adamfeuer/openstm32hw/Orone-mini-v0/Orone-mini-S8H-v0r001/Orone-mini-S8H-v0r001.brd

## EAGLE design Orone-mini-v0/Orone-mini-S8H-v0r001/Orone-mini-S8H-v0r001.brd (2013-06-28)

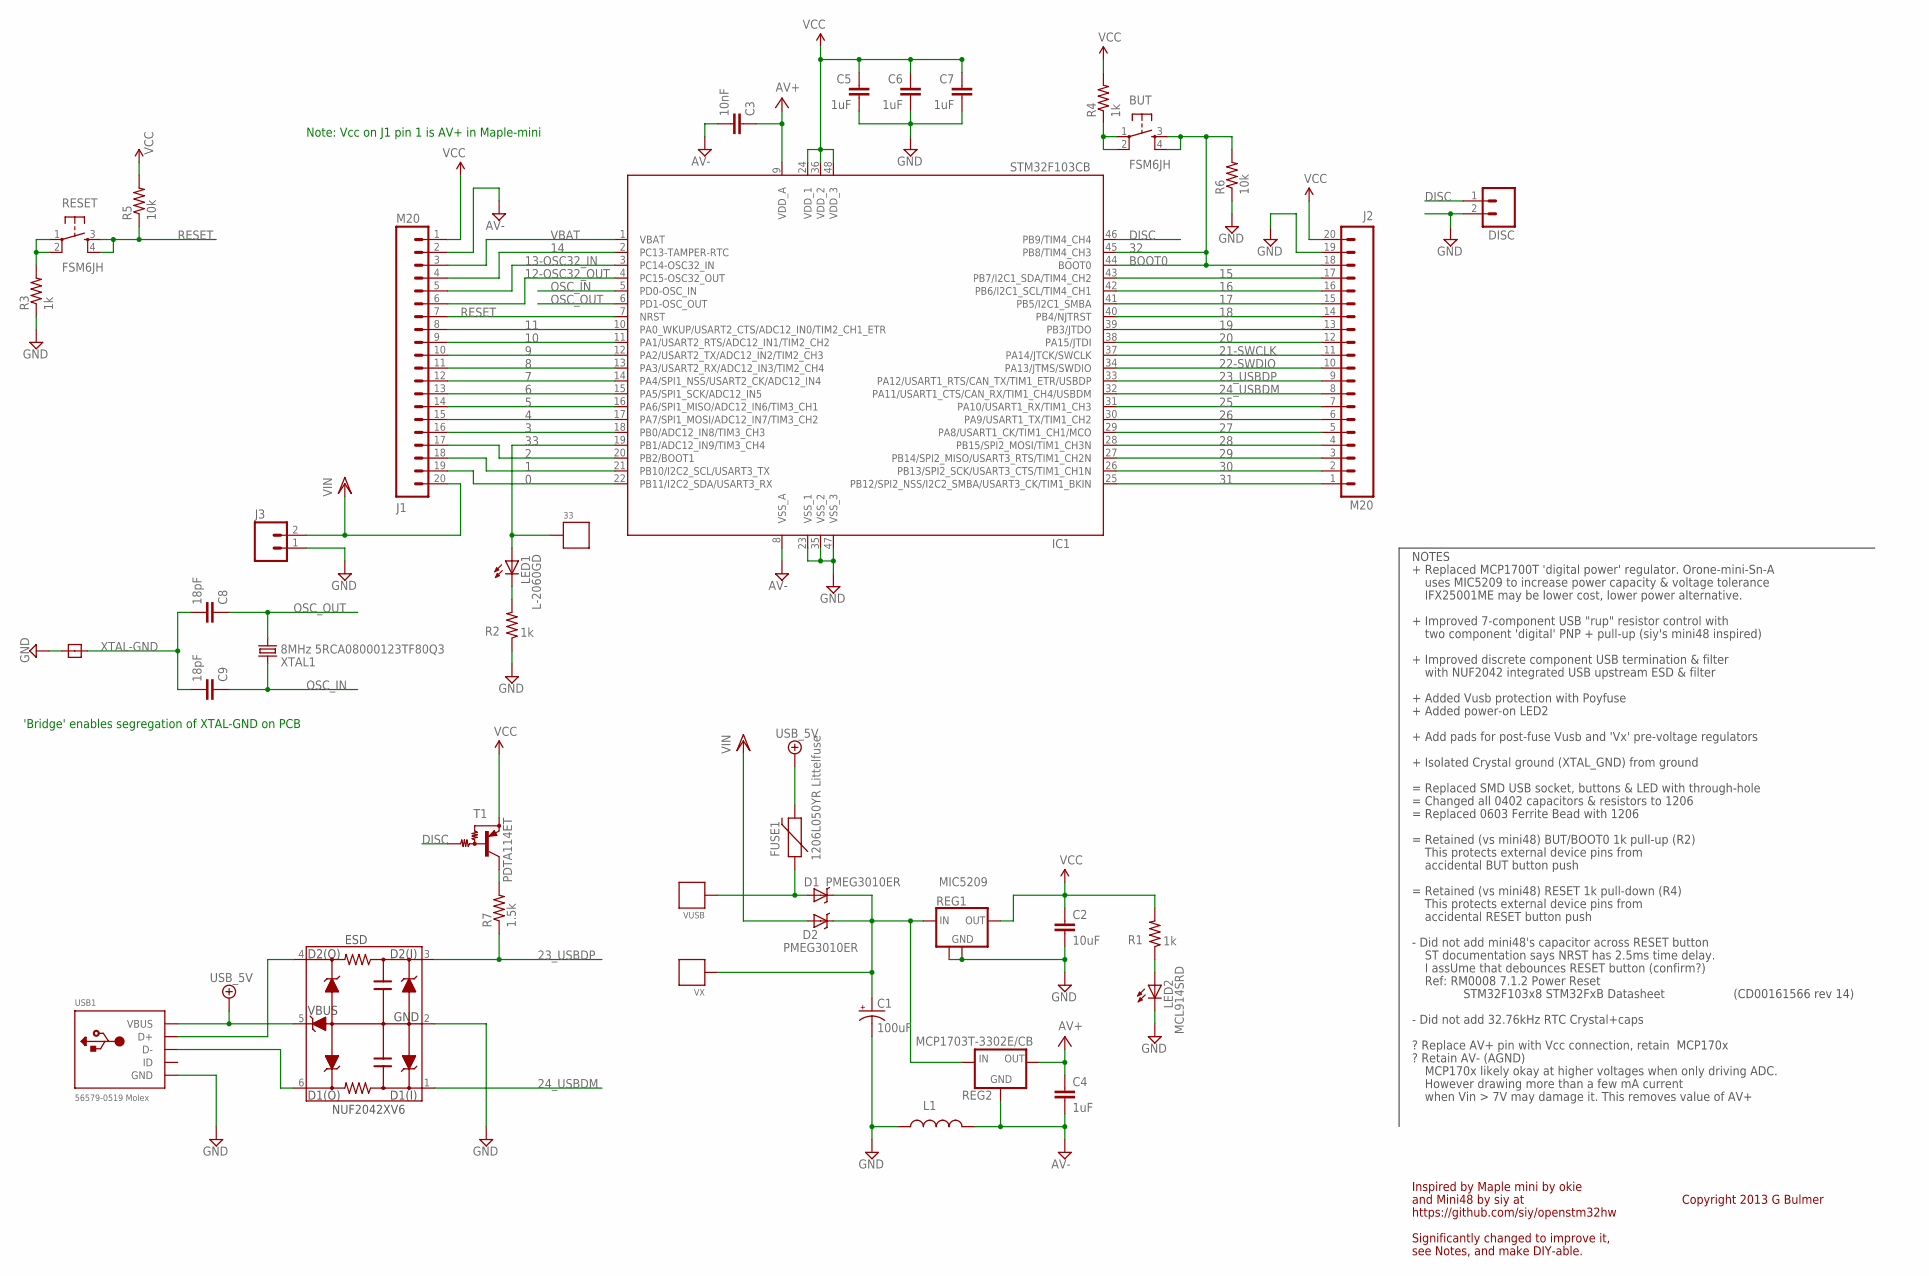
[picture p1: schematic Orone-mini-S8H-v0r001.sch]

Parts:
33: SIGNAL-PIN1; 1PIN
BUT: FSM6JH; TACTILE-PTH
C1: 100uF; EIA7343
C2: 10uF; 1206
C3: 10nF; 1206
C4, C5, C6, C7: 1uF; 1206
C8, C9: 18pF; 1206
D1, D2: PMEG3010ER; SOD-123W
DISC: M021X02_NO_SILK; 1X02_NO_SILK
ESD: NUF2042XV6; SOT563
FUSE1: 1206L050YR Littelfuse; PTC-1206
IC1: STM32F103CB; LQFP48
J1, J2: M20; 1X20
J3: M02POLAR; MOLEX-1X2
L1: INDUCTOR1206; 1206
LED1: L-2060GD; LED1.8MM-1MM
LED2: MCL914SRD; LED1.8MM-1MM
R1, R2, R3, R4: 1k; 1206
R5, R6: 10k; 1206
R7: 1.5k; 1206
REG1: MIC5209; SOT223-NT
REG2: MCP1703T-3302E/CB; SOT23
RESET: FSM6JH; TACTILE-PTH
T1: PDTA114ET; ES_SOT23-3
U$4: 2PIN-GND-BRIDGE08X08MILS; 2PIN-08X08
USB1: 56579-0519 Molex; USB-MINI-AB-TH-MOLEX-DRILL
VUSB: SIGNAL-PIN1; 1PIN
VX: SIGNAL-PIN1; 1PIN
XTAL1: 8MHz 5RCA08000123TF80Q3; CRYSTAL-SMD-5X3

Connections:
0: IC1.22 (PB11/I2C2_SDA/USART3_RX), J1.19
1: IC1.21 (PB10/I2C2_SCL/USART3_TX), J1.18
2: IC1.20 (PB2/BOOT1), J1.17
3: IC1.18 (PB0/ADC12_IN8/TIM3_CH3), J1.16
4: IC1.17 (PA7/SPI1_MOSI/ADC12_IN7/TIM3_CH2), J1.15
5: IC1.16 (PA6/SPI1_MISO/ADC12_IN6/TIM3_CH1), J1.14
6: IC1.15 (PA5/SPI1_SCK/ADC12_IN5), J1.13
7: IC1.14 (PA4/SPI1_NSS/USART2_CK/ADC12_IN4), J1.12
8: IC1.13 (PA3/USART2_RX/ADC12_IN3/TIM2_CH4), J1.11
9: IC1.12 (PA2/USART2_TX/ADC12_IN2/TIM2_CH3), J1.10
10: IC1.11 (PA1/USART2_RTS/ADC12_IN1/TIM2_CH2), J1.9
11: IC1.10 (PA0_WKUP/USART2_CTS/ADC12_IN0/TIM2_CH1_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), J1.8
12-OSC32_OUT: IC1.4 (PC15-OSC32_OUT), J1.6
13-OSC32_IN: IC1.3 (PC14-OSC32_IN), J1.5
14: IC1.2 (PC13-TAMPER-RTC), J1.4
15: IC1.43 (PB7/I2C1_SDA/TIM4_CH2), J2.17
16: IC1.42 (PB6/I2C1_SCL/TIM4_CH1), J2.16
17: IC1.41 (PB5/I2C1_SMBA), J2.15
18: IC1.40 (PB4/NJTRST), J2.14
19: IC1.39 (PB3/JTDO), J2.13
20: IC1.38 (PA15/JTDI), J2.12
21-SWCLK: IC1.37 (PA14/JTCK/SWCLK), J2.11
22-SWDIO: IC1.34 (PA13/JTMS/SWDIO), J2.10
23_USBDP: ESD.3 (D2(I)), IC1.33 (PA12/USART1_RTS/CAN_TX/TIM1_ETR/USBDP), J2.9, R7.1
24_USBDM: ESD.1 (D1(I)), IC1.32 (PA11/USART1_CTS/CAN_RX/TIM1_CH4/USBDM), J2.8
25: IC1.31 (PA10/USART1_RX/TIM1_CH3), J2.7
26: IC1.30 (PA9/USART1_TX/TIM1_CH2), J2.6
27: IC1.29 (PA8/USART1_CK/TIM1_CH1/MCO), J2.5
28: IC1.28 (PB15/SPI2_MOSI/TIM1_CH3N), J2.4
29: IC1.27 (PB14/SPI2_MISO/USART3_RTS/TIM1_CH2N), J2.3
30: IC1.26 (PB13/SPI2_SCK/USART3_CTS/TIM1_CH1N), J2.2
31: IC1.25 (PB12/SPI2_NSS/I2C2_SMBA/USART3_CK/TIM1_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), J2.1
32: BUT.3, BUT.4, IC1.44 (BOOT0), IC1.45 (PB8/TIM4_CH3), J2.18, R6.2
33: 33.P$1, IC1.19 (PB1/ADC12_IN9/TIM3_CH4), LED1.A
+5V/2: ESD.5 (VBUS), FUSE1.2, USB1.VBUS
AV+: C3.1, C4.1, IC1.9 (VDD_A), REG2.2 (OUT)
AV-: C3.2, C4.2, IC1.8 (VSS_A), J1.2, L1.2, REG2.1 (GND)
DGND: C1.C (-), C2.2, C5.2, C6.2, C7.2, DISC.2, ESD.2 (GND), IC1.23 (VSS_1), IC1.35 (VSS_2), IC1.47 (VSS_3), J2.19, J3.1, L1.1, LED2.C, R2.1, R3.1, R6.1, REG1.2 (GND), REG1.4 (GND), U$4.P$1, USB1.GND
DISC: DISC.1, IC1.46 (PB9/TIM4_CH4), T1.1 (B)
unnamed: BUT.1, BUT.2, R4.1
unnamed: LED1.C, R2.2
unnamed: D1.P$2.ANODE (A), FUSE1.1, VUSB.P$1
unnamed: R3.2, RESET.1, RESET.2
unnamed: LED2.A, R1.1
unnamed: C1.A (+), D1.P$1.CATHODE (C), D2.P$1.CATHODE (C), REG1.1 (IN), REG2.3 (IN), VX.P$1
unnamed: R7.2, T1.3 (C)
unnamed: ESD.4 (D2(O)), USB1.D+
unnamed: ESD.6 (D1(O)), USB1.D-
OSC_IN: C9.1, IC1.5 (PD0-OSC_IN), XTAL1.3 (2)
OSC_OUT: C8.1, IC1.6 (PD1-OSC_OUT), XTAL1.1
RESET: IC1.7 (NRST), J1.7, R5.1, RESET.3, RESET.4
VBAT: IC1.1 (VBAT), J1.3
VCC: C2.1, C5.1, C6.1, C7.1, IC1.24 (VDD_1), IC1.36 (VDD_2), IC1.48 (VDD_3), J1.1, J2.20, R1.2, R4.2, R5.2, REG1.3 (OUT), T1.2 (E)
VIN: D2.P$2.ANODE (A), J1.20, J3.2
XTAL-GND: C8.2, C9.2, U$4.P$2

Notes on the sheet:
BOOT0
NOTES
- Did not add 32.76kHz RTC Crystal+caps
? Retain AV- (AGND)
ST documentation says NRST has 2.5ms time delay.
Inspired by Maple mini by okie
and Mini48 by siy at
https://github.com/siy/openstm32hw
Copyright 2013 G Bulmer
I assUme that debounces RESET button (confirm?)
Ref: RM0008 7.1.2 Power Reset
STM32F103x8 STM32FxB Datasheet
(CD00161566 rev 14)
= Changed all 0402 capacitors & resistors to 1206
+ Replaced MCP1700T 'digital power' regulator. Orone-mini-Sn-A
uses MIC5209 to increase power capacity & voltage tolerance
+ Improved 7-component USB "rup" resistor control with
two component 'digital' PNP + pull-up (siy's mini48 inspired)
+ Improved discrete component USB termination & filter
with NUF2042 integrated USB upstream ESD & filter
= Replaced SMD USB socket, buttons & LED with through-hole
= Retained (vs mini48) RESET 1k pull-down (R4)
This protects external device pins from
accidental RESET button push
= Retained (vs mini48) BUT/BOOT0 1k pull-up (R2)
accidental BUT button push
- Did not add mini48's capacitor across RESET button
MCP170x likely okay at higher voltages when only driving ADC.
However drawing more than a few mA current
when Vin > 7V may damage it. This removes value of AV+
= Replaced 0603 Ferrite Bead with 1206
? Replace AV+ pin with Vcc connection, retain MCP170x
+ Added Vusb protection with Poyfuse
Note: Vcc on J1 pin 1 is AV+ in Maple-mini
'Bridge' enables segregation of XTAL-GND on PCB
+ Added power-on LED2
+ Isolated Crystal ground (XTAL_GND) from ground
Significantly changed to improve it,
see Notes, and make DIY-able.
IFX25001ME may be lower cost, lower power alternative.
+ Add pads for post-fuse Vusb and 'Vx' pre-voltage regulators

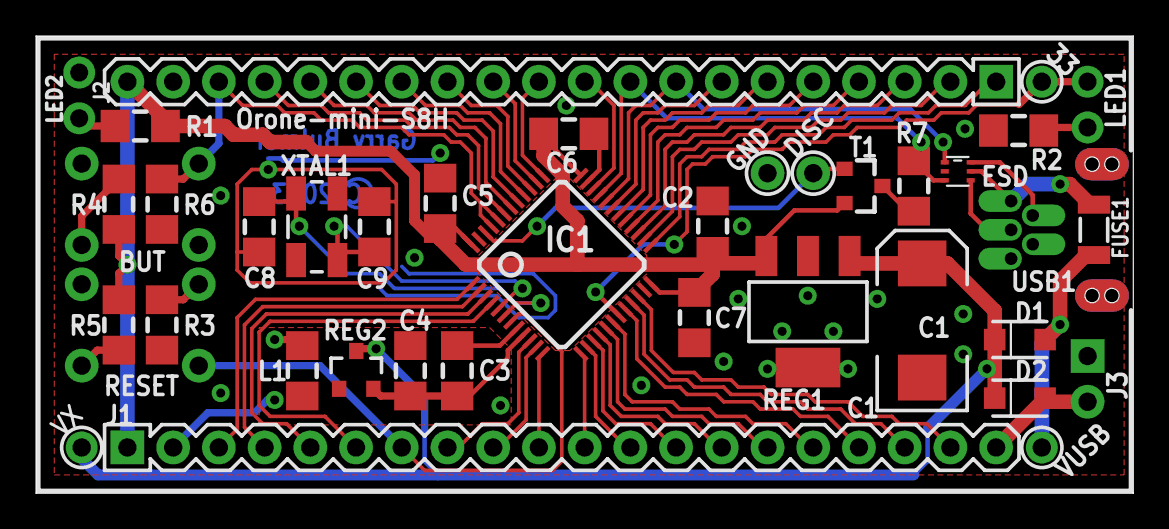
[picture p2: board Orone-mini-S8H-v0r001.brd from above]

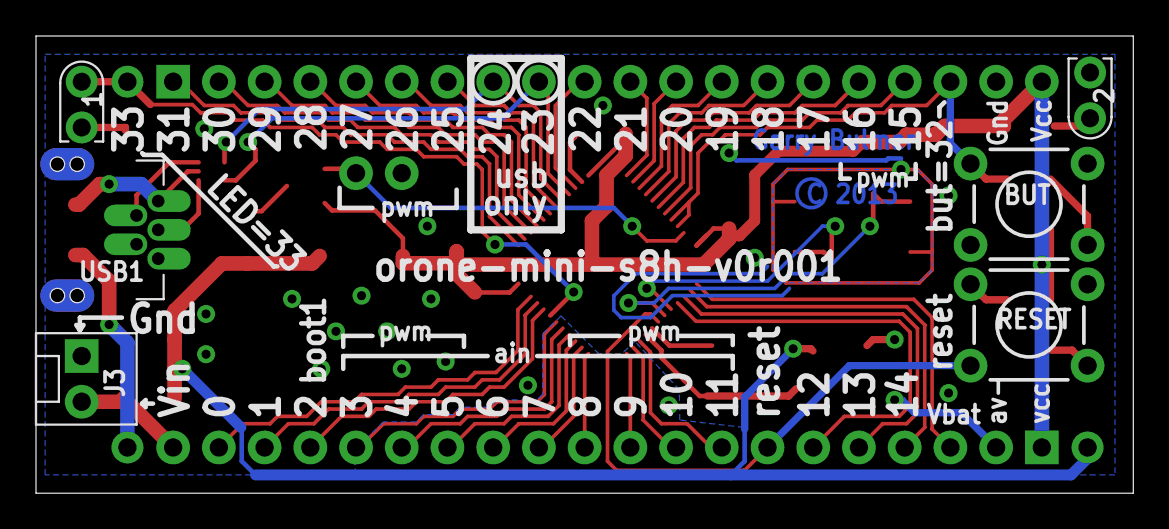
[picture p3: board Orone-mini-S8H-v0r001.brd from below]

Board: 2 copper layers, 61.0 x 25.4 mm, 39 parts (7 on the bottom side), 55 nets.
