adamfeuer/openstm32hw/(commit log)

2013-06-27 adding new Digikey BOM files
    [Orone-mini-S8H-v0r001-bom-Digikey2.csv, Orone-mini-S8H-v0r001-bom-Digikey2.xlsx]
2013-06-27 added 3 drill holes per side to the USB connector feet slots - to see if they will join into a continuous slot
    [Orone-mini-S8H-v0r001.brd]
2013-06-28 added 2 drill holes per connector foot to make the slots neater
2013-06-28 update board and schematic to use new usb conector package with added drill holes in overdrill style
    [Orone-mini-S8H-v0r001.brd, Orone-mini-S8H-v0r001.sch]
2013-08-28 corrected error in Digikey2 BOM - replaced incorrect 1206 capacitor with correct EIA7343 version that is known to work
    [Orone-mini-S8H-v0r001-bom-Digikey2.csv, Orone-mini-S8H-v0r001-bom-Digikey2.xlsx]
2013-08-28 added correct Digikey2 BOM - replaced incorrect 1206 capacitor with correct EIA7343 version that is known to work
    [Orone-mini-S8H-v0r001-bom-Digikey2.csv, Orone-mini-S8H-v0r001-bom-Digikey2.xlsx]
